marianatpimenta/IncreasingSafetyInMechanicalVentilatorSharing/README.md

# IncreasingSafetyInMechanicalVentilatorSharing

ALMA.pdf is the thesis assotiated with the development of ALMA (Autonomous Low-cost tidal volume Monitor and Alarm), and presents its principles, development, application, tests and results.

IncreasingSafetyInMechanicalVentilatorSharing.pdf is a brief description of the project and its results after simulation.

MaterialsAndUtilizationGuidelines.pdf contains a list of materials, a circuit diagram and final utilization instructions.

The code can be seen in SafetyProjectCode.ino.

contact via marianatpimenta@gmail.com.
